gvaparna/Interactive_Coffee_Mug/(commit log)

2020-07-02 Update README.md
    Adding Materials Required
2020-07-30 added implementing debugger sensor
